SudeepJoshi22/DHRUT-V/tests/bench/BENCHMARKING.md

# Benchmarking DHRUT-V

## Status and measurement boundary

Stage 1 validates the benchmark flow at **one iteration**. These measurements
are sensitive to startup state and are **not steady-state headline scores** or
comparisons with other processors. No hardware measurement or EEMBC
certification is claimed.

Dhrystone is the existing pqr5-derived **2.2** port with result self-checks.
CoreMark uses the pinned EEMBC sources listed in its [NOTICE](coremark/NOTICE.md).
Only its platform files differ from that upstream revision.

## Reproduce the runs

On this machine, the FPGA clone shares the stable clone's installed tools:

```bash
cd /home/sudeep/github/DHRUT-V-FPGA
source /home/sudeep/github/DHRUT-V/venv/bin/activate
```

That environment also adds GCC, Spike and Verilator to PATH. On another
machine, install those tools and cocotb/pyuvm first. Run simulations serially:
`tools/pyUVM` is a shared build directory. The memory contract check below uses
its own isolated build directory.

```bash
MEM_STALL_MODE=fixed CPU_TRACE=0 WAVES=0 \
  ./tools/simulate_c.sh dhrystone_fixed tests/bench/dhrystone/*.c -- \
  -DITERATIONS=1 -DDHRUTV_RTLSIM=1
./tools/bench_report.py dhrystone_fixed --kind dhrystone

MEM_STALL_MODE=fixed CPU_TRACE=0 WAVES=0 CYCLE_TIMEOUT=1000000 \
  ./tools/simulate_c.sh coremark_fixed tests/bench/coremark/*.c -- \
  -DITERATIONS=1 -DPERFORMANCE_RUN=1
./tools/bench_report.py coremark_fixed --kind coremark
```

`CPU_TRACE=0` skips the passive pipeline monitor and instruction tracer. The
DMEM monitor, result writes, tohost scoreboard, watchdog and RTL assertions
remain enabled. `WAVES=0` disables waveform generation. Neither changes the
benchmark's simulated clock. Trace generation stays on by default.

For benchmark sources, the C runner defaults to `fixed`; other C tests still
default to `random`. Explicit `MEM_STALL_MODE` overrides either default.
Each new build saves `build.json` with compiler version, complete command,
revision/dirty status, ELF/source hashes and trace/memory settings. The reporter
accepts `--json` to include those conditions. It refuses failed, unfinished,
zero-measurement or mismatched-ELF results.

### Compiler and flags

Measured with `riscv-none-elf-gcc (xPack GNU RISC-V Embedded GCC x86_64) 15.2.0`.
The C runner applies the same flags to every translation unit:

```text
-march=rv32im_zicsr -mabi=ilp32
-O2 -ffreestanding -fno-stack-protector -fno-builtin
-DCLOCKS_PER_SEC=1
-static -mcmodel=medany -fvisibility=hidden -nostdlib -nostartfiles
<per-benchmark defines shown above>
-T tests/linker_c.ld tests/crt0.S <benchmark sources> -lgcc
```

No LTO or additional benchmark-specific optimizer flags are used. This is a
fully disclosed build configuration, not a claim of independently audited
Dhrystone run-rule compliance. The reference is Spike with
`--isa=rv32im_zicsr -m0x80000000:0x10000`; the DUT uses Verilator/cocotb/pyuvm.

### Memory modes

| Mode | Behavior | Purpose |
|---|---|---|
| `fixed` | Capture in IDLE, synchronous read, response in RESP, then IDLE | FPGA BRAM handshake model |
| `zero` | Driver with no added stall loop | Controlled microarchitecture experiments |
| `random` | Data stalls 1–5 cycles; fetch stalls 1–2 cycles on roughly 40% of requests | Timing variation for regressions |

The fixed driver implements the response protocol of
`fpga/rtl/bram_slave.sv`. Checks cover both clock phases, held/back-to-back requests,
redirects, flushes, resets, data and byte-write strobes. Clocked RTL masters
also check simulator scheduling: the Python driver samples the preceding
half-cycle so it cannot accept a newly launched CPU request one edge early:

```bash
python3 tools/check_memory_timing.py
```

This establishes the tested memory protocol. The Python memory remains a
sparse backing store; it does not enforce FPGA capacity or upper-address
aliasing. End-to-end cycle equality with the physical board remains a hardware
cross-check, not an inference from where a score sits between other scores.

## Results and derivation

Only cycles between the benchmark's own start/stop `mcycle` reads enter the
calculation. Total cocotb runtime also includes startup, BSS initialization and
reporting and must not replace that interval.

```text
Dhrystone cycles/run = (stop_mcycle - start_mcycle) / runs
DMIPS/MHz           = 1,000,000 / (1757 * cycles/run)
CoreMark/MHz        = iterations * 1,000,000 / timed_cycles
```

Clock frequency cancels in these per-MHz expressions. The timing port uses a
32-bit difference: the interval must be shorter than 2^32 cycles.

Recorded simulation results use `fixed`, `CPU_TRACE=0`, `WAVES=0`.
The JSON reports identify the measured builds:

| Benchmark | Iterations | Timed cycles | Derived value | DUT result |
|---|---:|---:|---:|---|
| Dhrystone | 1 | 759 | 0.750 DMIPS/MHz | PASS |
| CoreMark, performance seeds | 1 | 383,043 | 2.611 CoreMark/MHz | PASS |

These are **flow-validation figures only**. The report JSONs in
[`results/`](results/) retain ELF hashes, commands and available build metadata.
Both records include automatically captured build conditions. The recorded
counts match native Verilator runs of `cpu_top` with 32 KB per memory.
This comparison covers RTL simulation. Board cycle equivalence requires a
measurement using the same program and conditions.

Both CoreMark seed configurations have Spike and DUT validation. The hardware
results below use the same protected sources and compiler configuration.

Verification includes memory-contract checks, protected-source hashes, five
Spike cases, reporter rejection checks and a deliberate DUT watchdog timeout.
These checks do not constitute a full ASM/RISCOF regression. The regular lint
script reports mixed-timescale warnings.

## Validation and reporting limits

```bash
python3 tools/check_coremark.py
```

This checks all six protected source hashes and runs these fast Spike cases:
performance seeds, validation seeds, a corrupted expected CRC in an ELF copy,
unknown seeds, and a one-iteration run with the real 27 MHz time conversion.
The first two must pass; the last three must fail. It also verifies that result
stores precede `tohost` and that failure is never overwritten by a later pass.
The CRC injection changes only a generated ELF, never benchmark source.

`CLOCKS_PER_SEC=1` deliberately suppresses CoreMark's duration gate for short
simulation checks. These runs **do not satisfy CoreMark reporting rules**.
Simulating enough target cycles is possible but expensive; simulator wall time
is not the benchmark's target execution time. The source and seed requirements
are separate from the duration requirement. Self-measured results and laboratory
certification are also separate claims.

[EEMBC's run and reporting rules](https://github.com/eembc/coremark/blob/1f483d5b8316753a742cbf5590caf5bd0a4e4777/README.md#run-rules)
require at least ten measured seconds, both specified seed sets, a 2,000-byte
buffer, consistent flags and unmodified protected sources. Keep compiler,
flags, iterations, memory configuration, platform and validation status beside
any published figure.

## Hardware results

The FPGA has 32 KB instruction and data memories, a 115200-baud UART, and a
checked serial loader. The runs below were loaded over UART and timed by the
CPU's `mcycle` counter at 27 MHz. The UART output is outside the measured
interval.

| Benchmark | Iterations | Timed cycles | Derived result | Result |
|---|---:|---:|---:|---|
| Dhrystone | 1,000 | 742,022 | 0.767 DMIPS/MHz | PASS |
| Dhrystone | 10,000 | 7,520,054 | 0.757 DMIPS/MHz | PASS |
| CoreMark, performance seeds | 1,000 | 383,046,474 | 2.610649 CoreMark/MHz | PASS |
| CoreMark, validation seeds | 1,000 | 384,258,223 | 2.602417 CoreMark/MHz | PASS |
| CoreMark, validation seeds | 5,000 | 1,920,795,731 | 2.603088 CoreMark/MHz | PASS |

The CoreMark runs each exceed ten seconds and both required seed sets pass.
The reportable performance result is **2.610649 CoreMark/MHz**. These are
self-measured hardware results; they are not EEMBC Certification Lab results.

The Dhrystone sweep is partial. The 1,000- and 10,000-iteration runs show the
startup cost is already small, but 1, 100 and 50,000 iterations remain before
using a converged Dhrystone figure as the headline result. A low-iteration
board run also remains to be compared directly with the fixed-mode simulation.
