SudeepJoshi22/DHRUT-V/rtl/pipeline/bpu.sv

`timescale 1ns / 1ps
`default_nettype none

import riscv_uop_pkg::*;

/**
 * Branch Prediction Unit (BPU)
 *
 * A fused BTB + 2-bit-saturating-counter BHT: one table, each entry
 * holding {tag, target, 2-bit state}. Indexed by the PC, tagged with the
 * full PC so aliasing is detected (a miss) rather than mispredicted.
 *
 * Separate prediction and update ports to allow for pipeline timing.
 *
 * Prediction port:
 *   i_is_branch_pred   - high when the instruction being fetched is a branch
 *   i_branch_pc_pred   - PC of the branch being fetched (for indexing)
 *   i_offset_pc_pred   - target PC of the branch (PC + immediate) to store on a miss
 *   o_prediction       - 1 if predicted taken, 0 if not taken
 *   o_predicted_pc     - predicted target PC (valid when o_prediction is high)
 *
 * Update port:
 *   i_branch_pc_update - PC of the branch whose outcome is known
 *   i_taken_update     - actual outcome (1 taken, 0 not taken)
 *   i_update_valid     - high when update is valid
 *
 * Parameters:
 *   TABLE_DEPTH: number of entries in the BPU (must be power of 2)
 *   INDEX_WIDTH: $clog2(TABLE_DEPTH)
 *   XLEN:        register width (32 for RV32)
 *
 * NOTE ON CORRECTNESS: nothing in here can make the core wrong. Every
 * prediction is re-resolved in Issue, which redirects on any mismatch.
 * A stale entry, an aliased index or a cold table costs cycles only.
 */
module bpu #(
    parameter int TABLE_DEPTH = 256,
    parameter int INDEX_WIDTH = 8,  // $clog2(TABLE_DEPTH)
    parameter int XLEN = 32,
    // Bits of PC kept as the hit tag. XLEN stores the whole PC, so a hit is
    // exact and only conflict misses are possible. A narrower tag makes the
    // entry (and the mux tree that reads it) smaller at the cost of false
    // hits between two branches sharing the same index AND the same low tag
    // bits -- which predicts the wrong target. That is a mispredict, not a
    // wrong result: Issue re-resolves every branch and redirects on any
    // mismatch, exactly as the header note says. Costs cycles only.
    parameter int TAG_WIDTH = XLEN
) (
    input  logic        clk,
    input  logic        rst_n,
    // Prediction port
    input  logic        i_is_branch_pred,
    input  logic [XLEN-1:0] i_branch_pc_pred,
    input  logic [XLEN-1:0] i_offset_pc_pred,
    output logic        o_prediction,
    output logic [XLEN-1:0] o_predicted_pc,
    // Update port
    input  logic [XLEN-1:0] i_branch_pc_update,
    input  logic        i_taken_update,
    input  logic        i_update_valid,
    input  logic [XLEN-1:0] i_update_target_pc   // Target PC to store on update
);

    // FSM States for 2-bit saturating counter
    typedef enum logic [1:0] {
        SNT = 2'b00, // Strongly Not-Taken
        WNT = 2'b01, // Weakly Not-Taken
        WT  = 2'b10, // Weakly Taken
        ST  = 2'b11  // Strongly Taken
    } bhu_state_t;

    // Branch History Table entry
    // Tag slice: PC[1:0] is always 0 for RV32 and PC[INDEX_WIDTH+1:2] is the
    // index itself, so the useful tag starts above the index.
    localparam int TAG_LSB = INDEX_WIDTH + 2;
    localparam int TAG_HI  = (TAG_LSB + TAG_WIDTH > XLEN) ? XLEN - 1
                                                          : TAG_LSB + TAG_WIDTH - 1;
    localparam int TAG_W   = TAG_HI - TAG_LSB + 1;

    typedef struct packed {
        logic [TAG_W-1:0] tag;
        logic [XLEN-1:0]  target_pc;
        bhu_state_t       state;
    } bhu_entry_t;

    // Unpacked table with one synchronous write port and asynchronous reads
    // for distributed-RAM inference.
    bhu_entry_t bhu [TABLE_DEPTH];

    // Prediction index and hit
    logic [INDEX_WIDTH-1:0] pred_idx;
    logic pred_hit;
    bhu_entry_t pred_bhu_entry;

    // Update index and hit
    logic [INDEX_WIDTH-1:0] upd_idx;
    logic upd_hit;
    bhu_entry_t upd_bhu_entry;

    // ─────────────────────────────────────────────────────────────────
    // Indexing
    // ─────────────────────────────────────────────────────────────────
    // Index from PC[INDEX_WIDTH+1:2], NOT PC[INDEX_WIDTH-1:0]. RV32
    // instructions are 4-byte aligned, so PC[1:0] is always zero: using
    // the raw low bits fed two constant zeros into the index and made
    // only one entry in every four reachable. A 256-entry table was
    // therefore behaving as a 64-entry one with a stride-4 hole pattern.
    assign pred_idx = i_branch_pc_pred[INDEX_WIDTH+1:2];
    assign upd_idx  = i_branch_pc_update[INDEX_WIDTH+1:2];

    // Check if we have a valid entry for prediction (hit)
    assign pred_hit = (bhu[pred_idx].tag == i_branch_pc_pred[TAG_HI:TAG_LSB]) && i_is_branch_pred;
    // Read the entry for prediction (always read, we'll use conditionally)
    assign pred_bhu_entry = bhu[pred_idx];

    // Check if we have a valid entry for update (hit)
    assign upd_hit = (bhu[upd_idx].tag == i_branch_pc_update[TAG_HI:TAG_LSB]) && i_update_valid;
    // Read the entry for update (always read)
    assign upd_bhu_entry = bhu[upd_idx];

    // Prediction logic: taken if state is WT or ST
    assign o_prediction = pred_hit && (pred_bhu_entry.state inside {WT, ST});
    assign o_predicted_pc = pred_hit ? pred_bhu_entry.target_pc : '0;

    // ─────────────────────────────────────────────────────────────────
    // Allocation policy: backward-taken / forward-not-taken
    // ─────────────────────────────────────────────────────────────────
    // A branch we have never seen gets a starting counter value from the
    // direction of its target rather than a flat WNT. A backward branch
    // is overwhelmingly a loop back-edge and is taken almost every time,
    // so starting it at WT gets the loop predicted correctly from its
    // second iteration instead of its fourth (WNT needs two taken
    // outcomes to reach WT). Forward branches keep WNT.
    bhu_state_t alloc_state;
    assign alloc_state = (i_offset_pc_pred < i_branch_pc_pred) ? WT : WNT;

    // ─────────────────────────────────────────────────────────────────
    // Table write
    // ─────────────────────────────────────────────────────────────────
    logic upd_fire, alloc_fire;
    bhu_state_t upd_next_state;

    assign upd_fire   = i_update_valid && upd_hit;
    assign alloc_fire = i_is_branch_pred && !pred_hit;

    always_comb begin
        unique case (upd_bhu_entry.state)
            SNT: upd_next_state = i_taken_update ? WNT : SNT;
            WNT: upd_next_state = i_taken_update ? WT  : SNT;
            WT : upd_next_state = i_taken_update ? ST  : WNT;
            ST : upd_next_state = i_taken_update ? ST  : WT;
        endcase
    end

    // Resolved updates take priority over allocations on the single write port.
    // Write the complete entry, including its matching tag.
    logic                        wr_en;
    logic [INDEX_WIDTH-1:0]      wr_idx;
    bhu_entry_t                  wr_data;

    always_comb begin
        wr_en   = upd_fire || alloc_fire;
        wr_idx  = upd_fire ? upd_idx : pred_idx;
        if (upd_fire) begin
            wr_data.tag       = i_branch_pc_update[TAG_HI:TAG_LSB];
            wr_data.target_pc = i_update_target_pc;
            wr_data.state     = upd_next_state;
        end
        else begin
            wr_data.tag       = i_branch_pc_pred[TAG_HI:TAG_LSB];
            wr_data.target_pc = i_offset_pc_pred;
            wr_data.state     = alloc_state;
        end
    end

    // Initialize the table at configuration/time zero for RAM inference.
    // Reset does not clear table entries.
    initial begin
        for (int i = 0; i < TABLE_DEPTH; i++) begin
            bhu[i].tag       = '0;
            bhu[i].target_pc = '0;
            bhu[i].state     = WNT;
        end
    end

    always_ff @(posedge clk) begin
        if (wr_en) bhu[wr_idx] <= wr_data;
    end

    // Optional simulation assertions (can be removed for synthesis)
    `ifdef SIMULATION
    // Ensure state never goes out of bounds
    assert property (@(posedge clk) disable iff (!rst_n)
        (bhu[pred_idx].state inside {SNT, WNT, WT, ST})
    ) else $error("BPU: Invalid state in table at prediction index %0d", pred_idx);
    assert property (@(posedge clk) disable iff (!rst_n)
        (bhu[upd_idx].state inside {SNT, WNT, WT, ST})
    ) else $error("BPU: Invalid state in table at update index %0d", upd_idx);

    // A hit means the stored tag matched the incoming PC's tag slice. With
    // TAG_WIDTH < XLEN this is deliberately weaker than full-PC equality:
    // two branches sharing an index and a tag slice alias, and the second
    // one gets the first's target. That is a mispredict, corrected by
    // Issue's redirect -- so the property to check is tag equality, not PC
    // equality. At the default TAG_WIDTH = XLEN the two coincide.
    assert_hit_implies_tag_match: assert property (@(posedge clk) disable iff (!rst_n)
        pred_hit |-> (bhu[pred_idx].tag == i_branch_pc_pred[TAG_HI:TAG_LSB])
    ) else $error("BPU: hit with mismatched tag at index %0d (pc=0x%h)", pred_idx, i_branch_pc_pred);

    // Two writers committing to one entry in a cycle is now structurally
    // impossible -- there is a single write port -- so the property worth
    // checking is the one the serialisation could actually break: a RESOLVED
    // update must never be dropped. Losing an allocation is by design;
    // losing an update would leave a stale counter or target in the table.
    assert_update_never_lost: assert property (@(posedge clk) disable iff (!rst_n)
        upd_fire |-> (wr_en && (wr_idx == upd_idx))
    ) else $error("BPU: resolved update at index %0d was not written", upd_idx);

    // And the write actually lands: next cycle the entry reads back what was
    // written, provided nothing overwrote it in between.
    assert_write_lands: assert property (@(posedge clk) disable iff (!rst_n)
        (wr_en && !$isunknown(wr_idx)) |=> (bhu[$past(wr_idx)] == $past(wr_data))
    ) else $error("BPU: write to index %0d did not land", $past(wr_idx));
    `endif

endmodule
