SudeepJoshi22/DHRUT-V/tests/bench/dhrystone/port.c

/* [DHRUT-V] port layer for upstream Dhrystone 2.2 (dhrystone.c/.h,
 * dhrystone_main.c vendored from iammituraj/pequeno_riscv, itself derived
 * from the classic Weicker/Pemberton C sources - see NOTICE).
 *
 * Replaces pqr5's memory-mapped hardware counter + UART ee_printf with:
 *  - mcycle CSR reads for Start_Timer()/Stop_Timer() (see the
 *    DHRUTV_RTLSIM branch added to dhrystone.h).
 *  - no-op ee_printf/uart_init (there's no UART on this core yet; the
 *    self-check dhrystone_main.c does instead reports pass/fail through
 *    the same `tohost` mechanism every other test uses).
 *  - minimal strcpy/strcmp needed by dhrystone.c/dhrystone_main.c,
 *    since we build with -nostdlib (no libc linked).
 */
#include "stats.h"
#ifdef DHRUTV_UART
#include "../coremark/core_portme_uart.h"
#endif

unsigned int start_cycles   = 0;
unsigned int elapsed_cycles = 0;
unsigned int end_cycles     = 0;

static unsigned int rdcycle(void) {
    unsigned int v;
    __asm__ volatile("csrr %0, mcycle" : "=r"(v));
    return v;
}

void uart_init(void) {
    /* no UART on this core (yet) */
}

int ee_printf(const char *fmt, ...) {
#ifdef DHRUTV_UART
    va_list args;
    va_start(args, fmt);
    uart_vprintf(fmt, args);
    va_end(args);
    uart_drain();
#else
    (void)fmt;
#endif
    return 0;
}

void setStats(int enable) {
    if (enable) {
        start_cycles = rdcycle();
    } else {
        end_cycles     = rdcycle();
        elapsed_cycles = end_cycles - start_cycles;
    }
}

char *strcpy(char *dst, const char *src) {
    char *d = dst;
    while ((*d++ = *src++) != '\0') {
    }
    return dst;
}

int strcmp(const char *a, const char *b) {
    while (*a && (*a == *b)) {
        a++;
        b++;
    }
    return (unsigned char)*a - (unsigned char)*b;
}

#ifdef DHRUTV_UART
void dhrutv_report(int fail, unsigned long runs, unsigned long cycles) {
    uart_printf("DHRUTV_RESULT dhrystone iterations=%lu cycles=%lu clock_hz=%lu errors=%lu\n",
                runs, cycles, (unsigned long)DHRUTV_CLOCK_HZ, (unsigned long)fail);
    *(volatile unsigned *)0x1000000cu = ((unsigned)fail << 1) | 1u;
}
#endif
