SudeepJoshi22/DHRUT-V/(commit log)

2024-05-01 Added RTL Trace and Compare Features
2024-11-07 Defined Standard interface and Memory Stage Implementation
2024-11-08 Memory stage interface verification
2024-11-08 Memory stage has been added to Core Pipe ,Yet to verify
2026-01-12 added yaml based monitor config, arithmetic instructions flowing through the pipeline correctly
    [alu_stage.sv, run_test.py]
2026-01-14 added LSU and assembly test
2026-01-21 added lsu-stall support, need to debug
    [issue.sv, lsu.sv, tb_top.sv]
2026-01-24 fixed fetch and lsu with forwarding and stalling, issue needs to be fixed
    [ifetch.sv, issue.sv, lsu.sv]
2026-01-24 stalling is working, finally pipeline is complete in terms of bring-up
    [ifetch.sv, issue.sv]
2026-02-11 scoreboard and pass/fail feature added, now time to find bugs
    [ifetch.sv, run_test.py]
2026-03-02 able to run tests with RISCOF framework, need to solve RTL bugs
    [alu_stage.sv]
2026-03-05 identified flaw in issue stage design, we should move to FSM based design
    [ifetch.sv, issue.sv, lsu.sv]
2026-03-06 mem test finally passing with to-host, updated issue to FSM based design
    [ifetch.sv, issue.sv, lsu.sv]
2026-03-08 lots of fixes towards full compliance with RV32I
    [decode.sv, ifetch.sv, issue.sv, lsu.sv, riscv_uop_pkg.sv, tb_top.sv]
2026-03-09 lots of important bug fixes, towards full rv32i compliance!
    [alu_stage.sv, ifetch.sv]
2026-03-14 m_flush introduced to the imem interface, many bugs are solved
    [ifetch.sv, issue.sv, mem_if.sv]
2026-03-17 fix in the issue, and RV32i_m compliance passing, robust install script to get started with DHRUT-V
    [issue.sv]
2026-06-01 BPU and AI slop cleanup
    [bpu.sv]
2026-08-21 Add branch predictor (BPU) wire-up, testbench trace logging, and riscof/test fixes
    - Wire up the existing bpu.sv into the pipeline: prediction port in ifetch,
    pred_taken/pred_target carried through the uop, and mispredict/redirect
    resolution in issue (actual outcome always trains the BPU; mispredict only
    fires when actual disagrees with the prediction).
    - Add cpu_deep_trace.log (per-cycle YAML-driven signal trace, extended
    monitor_config.yaml with BPU/mispredict/forwarding signals) and
    cpu_trace.log (Spike-style per-retired-instruction trace via new
    cpu_tracer.py).
    - Reorganize per-test artifacts (hex/elf/dis/spike log/sim log/traces/vcd)
    into a single directory per test run.
    -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
    [decode.sv, ifetch.sv, issue.sv]
2026-08-21 WIP: M7 CSR + trap groundwork (M-mode, RV32I_Zicsr)
    Adds a minimal M-mode-only CSR/trap unit, resolved in Issue at the same
    point branches/jumps already are (single-cycle read-modify-write; CSR
    read result passed through the ALU as op1+0 to reuse the existing
    Retire/write-back path):
    - rtl/pipeline/csr.sv: new CSR regfile — mstatus/misa/mie/mtvec/mscratch/
    mepc/mcause/mtval/mip/mcycle(h)/minstret(h)/mvendorid/marchid/mimpid/
    mhartid. mip hardwired 0 (no CLINT/PLIC yet). mtvec always direct-mode.
    - rtl/include/riscv_uop_pkg.sv: OPCODE_SYSTEM, OPCODE_MISC_MEM, uop_t.is_illegal.
    - rtl/pipeline/decode.sv: decodes CSRRW/S/C(+I), ECALL/EBREAK/MRET, FENCE
    (as a no-op). Unrecognized/reserve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
    [decode.sv, issue.sv, riscv_uop_pkg.sv]
2026-08-21 Verify M7 CSR/trap RTL end-to-end: 5/5 self-checking tests pass on real HW+Spike
    Ran the full toolchain (gcc/spike/verilator/cocotb, already built in this
    checkout's tools/ and venv/) against the M7 CSR/trap changes for real,
    via tools/simulate.sh:
    - csr_basic.S (already existed): CSRRW/S/C(+I) incl. the "no write when
    rs1/uimm==0" rule - PASS
    - tests/asm/trap_ecall.S (new): ecall trap - mcause==11, mepc == the
    ecall's own PC, mtval==0, mret returns past it - PASS
    - tests/asm/trap_illegal.S (new): illegal-instruction trap on a reserved
    opcode (.word 0xffffffff) - PASS, after a real fix below
    - tests/asm/trap_ebreak.S (new): breakpoint trap - mcause==3, mtval ==
    mepc == the ebreak's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
    [decode.sv, issue.sv, riscv_uop_pkg.sv]
2026-08-21 Update README: fix stale venv path, document CSR/trap status and SystemRDL workflow
    - Fix "Activate Environment": venv lives at venv/, not ~/riscv_pyenv/
    (install.sh has never created that path - this was always wrong).
    - Roadmap: CSR Support (Zicsr) is now implemented and directed-test-
    verified (was unchecked); note official riscof Zicsr/privilege
    compliance is still the remaining gate.
    - New "CSR / Trap Support (Zicsr, M-mode)" section: what's implemented,
    verification status, and an explicit explanation of how rtl/csr/'s
    SystemRDL spec fits in - it's a separate, manual validation step run
    by hand (peakrdl regblock / peakrdl html), NOT wired into simulate.sh/
    lint.sh/any bui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
2026-08-21 Wire the PeakRDL-generated CSR block into the real CPU, replacing the hand-written one
    The whole point of reverse-engineering csr.sv into SystemRDL was for the
    generated RTL to actually be the CSR block, not a side comparison artifact
    -- this makes that real. rtl/pipeline/csr.sv is deleted; issue.sv now
    instantiates rtl/csr/generated/csr_regfile_gen directly.
    - generate.sh: add --default-reset arst_n so the generated block matches
    this codebase's async-active-low reset convention instead of PeakRDL's
    default sync active-high.
    - issue.sv: CSR#->RDL-offset translation (mirrors csr_regfile.rdl's
    addrmap - see rtl/csr/README.md), a read mux sourced from hwif_out
    (bypasses the cpuif bus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
    [issue.sv]
2026-08-21 Split CSR/trap resolution out of issue.sv into rtl/pipeline/csr_unit.sv
    Per direction: keep Issue as a pure issuer (register read, forwarding,
    dispatch), treat CSR as its own block - unlike ALU/LSU (pipelined
    interface, resolved a cycle later), csr_unit resolves combinationally in
    the same cycle Issue holds a SYSTEM uop, same timing as branch/jump
    resolution, just factored out of issue.sv's body into its own module and
    instance (CSR_UNIT) instead of living inline.
    csr_unit.sv owns: CSR#->RDL-offset translation, the hwif_out-sourced read
    mux, RMW value computation, trap/ecall/ebreak/illegal detection, mret,
    and all hwif_in driving (trap entry, mret, mcycle/minstret increment) -
    i.e. everythi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
    [csr_unit.sv, issue.sv]
2026-08-21 README: trim the CSR bullet and roadmap line, still too verbose
    Cut the CSR Unit bullet back to a single short clause matching the rest
    of the pipeline breakdown's style, and shortened the roadmap line.
    Claude-Session: https://claude.ai/code/session_013TT9LfNpNbgpsU1Ze1F4HP
2026-08-22 riscof: add filter_testlist.py to exclude unimplemented pmp/misalignment tests
    Zicsr-gated test selection pulls in 119 tests, but 57 of them are for
    things this core doesn't implement: 43 pmp (no PMP CSRs - only gated on
    Zicsr in the suite's tags, not a real capability marker) and 14
    misalignment-trap tests (branch/jal/jalr/load/store - not implemented).
    filter_testlist.py strips both by path/filename pattern. Verified:
    119 -> 62 tests (38 I + 22 hints + 2 privilege: ecall.S, ebreak.S).
    Usage:
    riscof testlist --config config.ini --suite riscv-arch-test/riscv-test-suite \
    --env riscv-arch-test/riscv-test-suite/env --work-dir riscof_work
    python3 tools/riscof/filter_testlist.py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
2026-08-22 Fix LSU->Issue forwarding to gate on is_load, not just transaction-complete
    Root cause (found while digging into 13/22 "hints" riscof failures - see
    chat/commit history, unrelated to CSR work despite surfacing there):
    decode.sv extracts rd = instr[11:7] unconditionally for every instruction.
    For S-type (store) instructions those bits are actually imm[4:0], not a
    destination register - harmless on its own since writes_rd=0 suppresses
    the ARF write. But lsu.sv's completion signal (o_valid) fires for ANY
    finished transaction, load or store, and issue.sv's LSU-forwarding mux
    only checked "did a transaction just complete AND does its rd match
    rs1/rs2" - no check that the completing op was actual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
    [lsu.sv, tb_top.sv]
2026-08-23 Extract cpu_core.sv out of tb_top.sv
    tb_top previously instantiated every pipeline stage directly. Pull that
    into a standalone cpu_core module (imem_if/dmem_if as its only ports)
    so the CPU can be reused as a single unit by other integration work
    (benchmarking infra, future FPGA/SoC top-level), instead of tb_top
    being the only place the pipeline is wired together.
    Pure structural refactor, no behavioral change. Verified with 5
    tests/asm/*.S tests spanning ALU, branch/BPU, LSU forwarding, and CSR
    paths - all pass against Spike exactly as before.
2026-08-23 Add bare-metal C runtime and Dhrystone/CoreMark benchmark ports
    Bring-up path for performance measurement (next step after M7's CSR
    work, which already added real mcycle/minstret counters):
    - tests/crt0.S + tests/linker_c.ld: minimal C runtime (stack init,
    .bss zeroing, call main(), exit via the existing tohost convention).
    No newlib/UART needed since nothing here calls printf.
    - tools/simulate_c.sh: C-program counterpart to simulate.sh - compile,
    verify against Spike, run under Verilator/cocotb.
    - tests/c/hello_cycles.c proves the path end-to-end.
    - tests/bench/dhrystone and tests/bench/coremark: Dhrystone 2.2 and
    CoreMark 1.0 ported (vendored from iammituraj/pequeno_riscv's RTL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
2026-08-23 Fix instruction tracing: hierarchy regression + stale uop_t bit offsets
    cpu_trace.log had been empty for every test. Three separate defects:
    1. Hierarchy (regression from extracting cpu_core.sv): cpu_tracer.py and
    monitor_config.yaml address signals as tb_top.ALU / tb_top.if_id_valid,
    but those moved to tb_top.CORE.*. Every lookup silently AttributeError'd,
    so the tracer emitted nothing and cpu_monitor logged "Signal not found"
    for nearly every signal. Tests kept passing because pass/fail comes from
    tohost via the top-level dmem_if, so this went unnoticed.
    Fixed with a new hier.py that resolves signal paths against the core
    scope first, then the top level (so genuinely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
2026-08-23 Add ideal-memory mode and record pre-superscalar performance baseline
    Adds MEM_STALL_MODE to the imem/dmem drivers. Default (random) is
    unchanged: every data access stalls 1-5 cycles and ~40% of fetches stall
    1-2, which is deliberate - randomized timing shakes out handshake and
    flush bugs a fixed-latency model would hide. MEM_STALL_MODE=zero disables
    both, to measure the core's intrinsic IPC without synthetic memory latency
    dominating.
    Measured baseline (docs/performance_baseline.md) before starting
    superscalar work, since the widening decisions should follow the data:
    - IPC averages ~0.45 with the default memory model, ~0.68 with ideal
    memory - i.e. a good chunk of what looks like core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
2026-08-23 Add decoupling fetch queue between fetch and decode (Phase 1a)
    ifetch.sv had only a single-entry instruction buffer, so any imem stall
    immediately starved decode/issue. Adds rtl/pipeline/fetch_queue.sv - a
    parameterised (DEPTH=8) FWFT FIFO of {pc, instr, pred_taken, pred_target}
    with single-cycle synchronous flush - kept as its own module rather than
    inlined into ifetch.sv.
    The only functional change in ifetch.sv is the request condition:
    assign imem.m_valid = !i_flush && (!fq_full || fq_pop);
    // was: !i_flush && (!instr_valid_q || !i_stall)
    so fetch keeps running ahead while the queue has space. pc_q, the
    pre-decode, and the BPU query are untouched. cpu_core.sv needs no c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
    [fetch_queue.sv, ifetch.sv]
2026-08-23 64-bit instruction fetch: 2 instructions per access (Phase 1b)
    Phase 1a's queue gained only ~4% because fetch itself was the bottleneck
    at 1 instruction/cycle. This widens the fetch path so one access returns
    both instructions of an 8-byte aligned block.
    - mem_if gains a DATA_W parameter (default 32). imem is instantiated at
    64 in tb_top; dmem and every other user keep the 32-bit default, so the
    LSU path is untouched.
    - ifetch.sv requests the aligned block containing pc_q and pre-decodes
    both slots against their own PCs. pc_q[2] selects usable slots: at
    offset 4 only the upper word is usable, and that waste happens only on
    the first access after a redirect.
    - The BPU stays single-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
2026-08-24 imem driver: don't answer a fetch the core has withdrawn
    Dhrystone failed (tohost=0x1027) after 64-bit fetch landed, with the
    retired-instruction trace showing PCs paired with instructions from
    entirely different addresses - 0x80000588 carrying the word that lives
    at 0x80000d50. Root cause is in the testbench memory model, not the RTL.
    imem_driver injects fetch latency by awaiting clock edges, checking
    m_flush BEFORE each await. m_flush is a single-cycle pulse, so a
    mispredict flush landing during an awaited cycle is missed entirely.
    The driver then asserts s_ready carrying data sampled for the OLD
    address, while the core has already redirected pc_q to a new block --
    so the core pairs the N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
2026-08-24 gtkwave: rebuild signals.gtkw for the current pipeline
    The save file was stale in two ways. Every path was tb_top.* but the
    pipeline moved into the cpu_core instance (tb_top.CORE.*), and it
    referenced IF.instr_valid_q / instr_pc_q / instr_q, the single-entry
    instruction buffer that the fetch queue replaced - so those traces
    would simply not resolve.
    Rebuilt as a stage-by-stage walk of one instruction:
    IMEM (now 64-bit s_rdata) -> Fetch (pc_q, aligned_addr, both slots
    with their own pc/instr, per-slot pre-decode, BPU query select, group
    truncation and next_pc, the two queue push ports) -> Fetch Queue
    (push0/push1/pop fire, occupancy, free_slots, full/empty, pointers)
    -> queue head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
2026-08-24 Enable SVA assertions in simulation (+define+SIMULATION --assert)
    Every SVA check in the RTL is wrapped in `ifdef SIMULATION`, and nothing
    in the build ever defined it - so all nine assertions across ifetch.sv,
    fetch_queue.sv and bpu.sv were dead code in the normal flow. That was
    costly: fetch_queue's assert_no_overflow would have caught the
    queue-overflow bug (an instruction silently dropped, later surfacing as
    a wrong result) the moment it happened, instead of it being found by
    diffing an 11,000-instruction Dhrystone trace against Spike.
    Adds `--assert +define+SIMULATION` to EXTRA_ARGS. Both flags are needed:
    the define compiles the assertions in, --assert makes Verilator evaluate
    them.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
    [fetch_queue.sv]
2026-08-24 2-wide instruction decode (superscalar Phase 2)
    Decode now holds and decodes two instructions per cycle. Issue is still
    1-wide, so this does not change IPC on its own - it builds and verifies
    the front-end width that Phase 3 (dual issue) needs, without carrying an
    untested second lane into the risky phase.
    What changed:
    * rtl/pipeline/decoder.sv (new) - the whole combinational RV32I_Zicsr
    decode extracted out of decode.sv as a stateless module. One
    instruction in, one uop_t out. Instantiating two of these is what makes
    a 2-wide decode possible without duplicating 150 lines of case
    statement.
    * rtl/pipeline/decode.sv - rewritten as a 2-entry compacting buffer
    (the IF/ID pipeline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
    [cpu_core.sv, decode.sv, decoder.sv, fetch_queue.sv, ifetch.sv, issue.sv]
2026-08-25 Dual issue + dual retire (superscalar Phase 3)
    The core now issues and retires two instructions per cycle. Aggregate IPC
    on the nine baseline tests goes 0.739 -> 0.966 (+31%), and five of them
    cross 1.0 IPC for the first time.
    Issue and retire had to widen together: the moment two instructions are
    in flight per bundle, retire.sv's fixed ALU-over-LSU priority silently
    drops a result and the ARF's single write port loses one. There was no
    testable intermediate state.
    ## Design
    Asymmetric lanes. Lane 0 takes any instruction; lane 1 takes simple ALU
    ops only (OP / OP-IMM / LUI / AUIPC). Everything lane 1 refuses needs a
    unit that exists exactly once, so this keeps lsu.sv, csr_unit.sv and
    bpu.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
    [ARF.sv, alu_stage.sv, cpu_core.sv, csr_unit.sv, forward_unit.sv, issue.sv, issue_hazard.sv]
2026-08-25 BPU: return address stack, plus three defects in bpu.sv
    Dhrystone 1261 -> 1184 cycles/run, 0.451 -> 0.481 DMIPS/MHz (+6.7%).
    Directed-test `jumps` 0.633 -> 0.721 IPC (+14%). The Phase-3-only figure
    was measured by stashing just these files and re-running, so the split
    between dual issue and this change is measured, not inferred.
    ## Return address stack (rtl/pipeline/ras.sv, new)
    JALR was the only control transfer the core could not predict at all -
    issue.sv hardcoded `branch_mispredict_r = 1'b1` for every one of them, so
    every function return cost a full flush. At 2-wide issue each of those
    throws away twice as many issue slots as it did at 1-wide, which is what
    made this the highest-value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
    [bpu.sv, ifetch.sv, issue.sv, ras.sv]
2026-08-26 Fix two SV compilation-unit portability bugs; add BUILD_ONLY to simulate.sh
    Both RTL fixes are things Verilator's laxness hid and yosys+slang caught
    during FPGA elaboration.
    lsu.sv had no file-scope `import riscv_uop_pkg::*;` yet used uop_t. This
    works under Verilator because it puts every file in one shared $unit, so
    another file's import leaks in. slang follows the LRM: one compilation
    unit per file, imports do not leak. Real portability bug, not a slang
    quirk.
    issue.sv referenced dispatch_en from the buffer FSM above its own
    declaration. Legal for Verilator, rejected by strict elaborators. Pure
    declaration-order move -- the assign and all its dependencies are
    unchanged.
    simulate.sh gai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
    [issue.sv, lsu.sv]
2026-08-26 FPGA Phase 1: synthesizable cpu_top, BSRAM memories, LED bringup test
    Makes the core synthesizable for the Tang Nano 20K and gives it a
    visible sign of life, with LEDs as the only indicator. UART is deferred
    (design captured in fpga/UART_PLAN.md).
    cpu_top.sv is the synthesis top. cpu_core cannot be one itself: its ports
    are SystemVerilog interfaces, which are not wires until something
    instantiates them, and a .cst can only constrain flat scalar ports --
    hence yosys' "top-level module 'cpu_core' has unconnected interface port
    'imem_if'". cpu_top instantiates the two mem_if buses, terminates them in
    BSRAM, and exposes only clk/rst_n/led.
    bram_slave.sv replaces the cocotb memory drivers in ha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
    [bram_slave.sv, cpu_top.sv, mkmem.py]
2026-08-26 Separate the synchronous flush from the asynchronous reset in six always_ff
    yosys+slang rejects `always_ff @(posedge clk or negedge rst_n)` whose body
    starts `if (!rst_n || i_flush)`:
    error: condition cannot be matched to any signal from the event list
    note: asynchronous load pattern implied by edge sensitivity on multiple
    signals
    Two edges in the sensitivity list declare exactly two asynchronous load
    conditions, but the branch condition names i_flush, which is not one of
    them. i_flush is a synchronous clear, so it belongs in its own branch.
    Verilator accepts the fold; slang is right to refuse it.
    Behaviour is unchanged. The block only ever executes on posedge clk or
    negedge r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
    [alu_stage.sv, fetch_queue.sv, ifetch.sv, issue.sv, retire.sv]
2026-09-14 FPGA area: fit the core toward the GW2AR-18, and fix a dead data memory
    cpu_top synthesised 3.4x over the part: 71,353 LUT+ALU against 20,736,
    and 19,845 FFs against 15,552. No bitstream had ever been built. Four
    changes, none of which alters the instruction stream.
    1. BPU table 256 -> 32 entries (rtl/cpu_core.sv)
    bpu.sv holds a 66-bit entry in a PACKED array with an async reset over
    every entry, so it can never infer as BSRAM or LUT-RAM. It became
    16,896 FFs -- 85% of the whole design's registers -- plus two 256:1 x
    66-bit read mux trees and a 256-way write decoder. This one array was
    most of the overage.
    Measured IPC across depths 256/128/64/32/16 with MEM_STALL_MODE=z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
    [bpu.sv, bram_slave.sv, cpu_core.sv, lsu.sv, mkmem.py]
2026-09-14 Add per-module area report, plus formally-proven ALU/LSU datapath sharing
    AREA TOOLING (fpga/area_report.py, `make area`)
    Area work here was being steered by cell counts taken before techmap, and
    that produced a wrong answer: shrinking the fetch queue from depth 8 to 4
    removed 2,771 cells in the pre-map stat and then ADDED 2,750 LUTs once
    ABC9 had run, because depth 4 pushed the queue out of a shift-register
    shape. It passed every test and was still the wrong change. Pre-map cell
    counts do not predict post-ABC9 LUTs.
    So the script always runs synth_gowin to completion, and --compare shows
    the delta PER MODULE rather than in aggregate, which is what makes that
    class of mistake visible inste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
    [alu.sv, alu_equiv.sv, area_report.py, lsu.sv, lsu_equiv.sv]
2026-09-14 BPU table into distributed RAM: 23,803 -> 19,724 LUT4, now under budget
    A real nextpnr-himbaechel run -- the first ever on this design -- gave the
    authoritative picture and corrected two assumptions:
    LUT4 23932/20736 115% <- the actual overage
    ALU 1008/15552 6% <- SEPARATE pool, not competing for LUT4
    RAM16SDP4 0/ 648 0% <- distributed RAM, entirely unused
    DFF 4758/15552 30%
    BSRAM 8/ 46 17%
    So ALU cells were never LUT pressure (area_report.py counted them as such
    and has been corrected), and the part had 648 distributed-RAM blocks
    sitting idle while the branch predictor burned thousands of LUT4s.
    Three structural properties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
    [area_report.py, bpu.sv]
2026-09-14 BPU table 32 -> 16 entries: 19,724 -> 17,015 LUT4 (82.1% of budget)
    The table moved into distributed RAM in the previous commit but stayed 32
    entries deep. RAM16SDP4 is 16 deep (abits 4 in gowin/lutrams.txt), so 32
    entries needed two banks plus the address decode and output mux to select
    between them -- and that selection logic cost more than the storage it was
    selecting. At 16 the table is exactly one bank and the bank logic vanishes.
    LUT4 19,724 -> 17,015 (-2,709) 82.1% of 20,736
    LUT-RAM 30 -> 15
    FF 3,350 -> 3,350
    nextpnr confirms 18,143/20,736 = 87%, comfortably placeable, where the
    32-entry version was 20,972 = 101% and failed with "Unable to find lega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
    [cpu_core.sv]
2026-09-14 Close the fit: -nowidelut + a 27 MHz constraint, and document the whole effort
    THE DESIGN NOW BUILDS A BITSTREAM. fpga/cpu_top.fs places, routes and meets
    timing at 27 MHz (Fmax 33.06 MHz, ~22% margin).
    synth_gowin -nowidelut (fpga/Makefile SYNTH_OPTS)
    Being under budget turned out not to be enough. At 87% LUT4 the design
    placed and then would NOT route: nextpnr thrashed for 65 minutes with
    overused wires climbing 18 -> 426 across 136,000 iterations. Utilisation
    is necessary, not sufficient.
    Mapping to plain LUT4s instead of the MUX2_LUT5..8 wide-LUT tree fixes it,
    and is counter-intuitively SMALLER rather than larger:
    default -nowidelut
    LUT4 (yosys) 17,015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
    [area_report.py]
2026-09-14 install.sh: add an `fpga-tools` subcommand for the OSS CAD Suite
    The FPGA toolchain was never installed by any script -- tools/oss-cad-suite
    had to be fetched and unpacked by hand, and nothing in the repo recorded
    where it came from or which release was in use.
    It is now a subcommand rather than part of the default install, for two
    reasons. It is a ~1.5 GB download that work on rtl/ and tests/ does not
    need, and OSS CAD Suite ships its own Verilator and Python which would
    shadow the venv's if both were ever on PATH at once -- so the two
    environments are meant to be activated one at a time, and the help text
    says so.
    ./tools/install.sh # unchanged: GCC, Spike, Verilator, venv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
2026-09-14 fpga: add a README, and fix two things writing it uncovered
    fpga/README.md documents the flow end to end: how cpu_top is synthesised
    and why the wrapper has to exist at all, how the program gets into the
    bitstream, every make target and variable, the commands actually used day
    to day, how to read the six LEDs (including a symptom -> cause table for a
    dark board), and the known rough edges.
    Two bugs found by checking the commands before documenting them, rather
    than after:
    blink.f did not exist. Only blink.v was committed, so the Makefile's
    default FILELIST pointed at a missing file and `make check TOP=blink
    FILELIST=blink.f` -- the documented smoke test, and the first thing you
    should run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
2026-09-14 fpga: reset button is ACTIVE HIGH on this board -- fix the inverted polarity
    Flashed to hardware, the CPU ran only while S1 was held down. The reset was
    inverted: cpu_top.sv assumed the usual pull-up / press-to-ground wiring, so
    with the button released the core sat permanently in reset, which on the LED
    panel is indistinguishable from a dead CPU.
    Measured rather than guessed. fpga/pinprobe.v mirrors any input pin onto
    led0 -- the one LED pin confirmed in this repo (pin 15, from
    tangnano20k.cst) -- as blink-for-1, solid-for-0, which sidesteps the
    circular problem of using unverified LEDs to debug unverified pins. On the
    board it showed pin 88 reading 0 RELEASED and 1 PRESSED.
    So pin 88 IS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
    [cpu_top.sv, pinprobe.v]
2026-09-17 RV32M: add the multiply/divide unit, formally verified against a reference
    First half of the M extension: rtl/pipeline/mdu.sv, a standalone execution
    unit. It deliberately knows nothing about uop_t, the issue interfaces or
    the scoreboard -- it takes funct3 and two operands and returns a result --
    so it can be verified on its own, and a bug in the unit cannot later be
    confused with a bug in the pipeline integration.
    Written from the algorithms, not from anyone's code:
    MULTIPLY -- one 33x33 signed multiply serves all four forms. Each operand
    is extended with its OWN signedness, so MULHSU falls out by flipping one
    extension bit instead of needing separate hardware. synth_gowin maps `*`
    onto t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
    [mdu.sv, mdu_equiv.sv]
2026-09-18 RV32M: wire the MDU into the pipeline, non-blocking, and fix three bugs
    The multiply/divide unit from the previous commit is now reachable from
    software. tests/asm/mul_div.S passes: all eight operations, divide by zero,
    -2^31 / -1 overflow, MULHSU, and the pipeline interactions. Full asm
    regression 32/32.
    INTEGRATION
    uop_t one is_mdu bit, declared FIRST so existing offsets hold.
    funct3 already selects which of the eight ops, exactly as
    it does for loads and stores, so one bit is enough.
    decoder.sv is_mdu = (funct7 == 7'b0000001).
    issue.sv lane-0 dispatch arm, structural stall, scoreboard set.
    retire.sv third result source, checked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
    [cpu_core.sv, decoder.sv, issue.sv, issue_hazard.sv, mdu.sv, mdu_equiv.sv]
2026-09-18 RV32M passes riscof 8/8: fix a bypass hit that masked a pending MDU write
    riscof's M suite caught a real bug that both the directed test and the
    formal proof missed. All 8 tests failed, but narrowly -- 2 signature words
    out of 616 -- and the disassembly pinned it exactly:
    addi x31, x31, 1285 -> x31 = 0xb505, live in the bypass network
    mul x31, x31, x31 -> dispatched to the MDU, several cycles out
    sw x31, 0(x1) -> stored 0xb505, the STALE value
    Operand readiness was `!busy || bypass_hit`, and bypass_hit was true from
    the addi. The bypass network matches on rd alone and has no notion of age.
    That is safe only while every producer is single-cycle and in-order,
    becaus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
    [issue.sv]
2026-09-18 pyUVM: make VCD tracing optional (WAVES=0)
    --trace --trace-structs was unconditional, so every run wrote a dump.vcd --
    123 MB for one Dhrystone iteration, and CoreMark is orders of magnitude
    longer. WAVES=0 turns it off; waves stay on by default because that is what
    you want while debugging.
    cpu_trace.log is still written either way, so the Spike comparison and IPC
    numbers are unaffected.
    Measured honestly: the speed benefit is marginal. Dhrystone ran at 2071
    ns/s with waves and 1913 ns/s without, on different memory modes, so the
    per-cycle Python tracer -- not the VCD writer -- is what dominates
    simulation throughput. The real win here is the 123 MB per run, which
    matters when a benchmark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
2026-09-18 coremark: fix two port gaps that stopped it compiling at all
    CoreMark had never been built. Two undefined symbols, both from the port
    assuming a hosted environment it does not have:
    FLAGS_STR COMPILER_FLAGS defaults to it, and upstream expects the
    build system to pass -DFLAGS_STR="...". Ours does not, so
    core_main.c failed on an undeclared identifier. It is only
    handed to ee_printf, which is a no-op stub here, so the
    content is cosmetic -- but it has to exist. Added a
    fallback, still overridable with -DFLAGS_STR.
    CLOCKS_PER_SEC EE_TICKS_PER_SEC was (CLOCKS_PER_SEC / TIMER_RES_DIVIDER),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
    [core_portme.c, core_portme.h]
2026-09-19 Make benchmark validation reliable and record reproducible baselines
    Restore protected CoreMark sources, require a real validation verdict, and store results before signaling completion. Model the FPGA BRAM handshake in fixed mode and allow passive CPU tracing to be disabled.
    Record one-iteration flow checks: Dhrystone 724 cycles; CoreMark 355050 cycles. Both DUT runs pass. Both seed sets and three negative cases pass their expected Spike checks; memory contract, reporter, and timeout checks pass. No full ASM/RISCOF rerun. Structural lint passes with existing timescale warnings nonfatal.
    [core_portme.c, core_portme.h]
2026-09-19 Sample fixed-memory requests before clocked RTL updates
    A complete cpu_top BRAM cross-check exposed an NBA scheduling gap missed by the original falling-edge stimulus test. Snapshot the master's stable request before the rising edge; add clocked RTL masters to the contract test.
    Dhrystone now measures 758 cycles and CoreMark 383043 cycles at one iteration. Both pass and exactly match native Verilator runs with the FPGA BRAM wrapper. Replace the previous flow-validation reports with automatically captured conditions. No core pipeline changes.
    [memory_timing.sv, test_memory_timing.py]
2026-09-19 Start FPGA hardware benchmarking with larger BRAM and a tested UART
    Expand instruction/data memory to 32 KB, reject image and stack overflow, move the LED snoop, and rebuild netlists when memory images change. Add a native cpu_top BRAM check and a standalone UART with CPU registers and loader channels.
    Both benchmark runs pass against real BRAM RTL and match corrected fixed-mode timing: Dhrystone 758 cycles, CoreMark 383043. Capacity tests and UART loopback/FIFO/framing/ownership tests pass. Flat synthesis: 15049 LUT4, 31/46 BSRAM. Loader, decoder and UART top-level integration are pending; no board flashing or hardware score claimed.
    [check_bram.py, check_uart.py, cpu_top.sv, mkmem.py, test_mkmem.py, test_uart.py, uart.sv, uart_tb.sv]
2026-09-19 Complete FPGA UART benchmark flow
2026-09-20 Document complete FPGA UART board flow
2026-09-20 Explain UART serial permission failures
    [loadprog.py]
2026-09-20 Add staged FPGA and UART bringup
2026-09-20 Pace FPGA UART program uploads
2026-09-22 Describe current implementation directly in documentation
2026-09-22 Keep source comments concise and describe current behavior
